Autonomous-Motorsports-Purdue/AMP_RCv2/(threads)

Thread 2 (2024-04-13):

Incorrect inductor footprint

benjamin-owen, 2024-04-13:
PCB footprint too small

Thread 3 (2024-04-13):

Missing switch on/off text

benjamin-owen, 2024-04-13:
Text should be added to PCB indicating which direction is on/off for the switch

benjamin-owen, 2024-05-23:
On is currently "down" position, consider flipping this.

Thread 4 (2024-04-13):

Jumper to bypass battery altogether

benjamin-owen, 2024-04-13:
A tiny slide switch or solder jumper should be added allowing the controller to be powered entirely via USB-C, not requiring a battery at all.

benjamin-owen, 2024-05-23:
Might not be needed, need to test and make sure using micro USB on Nucleo will power everything on board sufficiently.

Thread 7 (2024-09-01):

Anti-Spark Mosfet replacement

ZacharyGuM, 2024-09-01:
The overall design should be fine, The mosfets should be replaced. Focus on part selection and rerouting if necessary. https://github.com/Autonomous-Motorsports-Purdue/Anti-Spark/tree/main/Hardware
