Autonomous-Motorsports-Purdue/AMP_RCv2/hardware/AMP_RCv2.kicad_pcb

## KiCad design hardware/AMP_RCv2.kicad_pcb (2024-04-04)

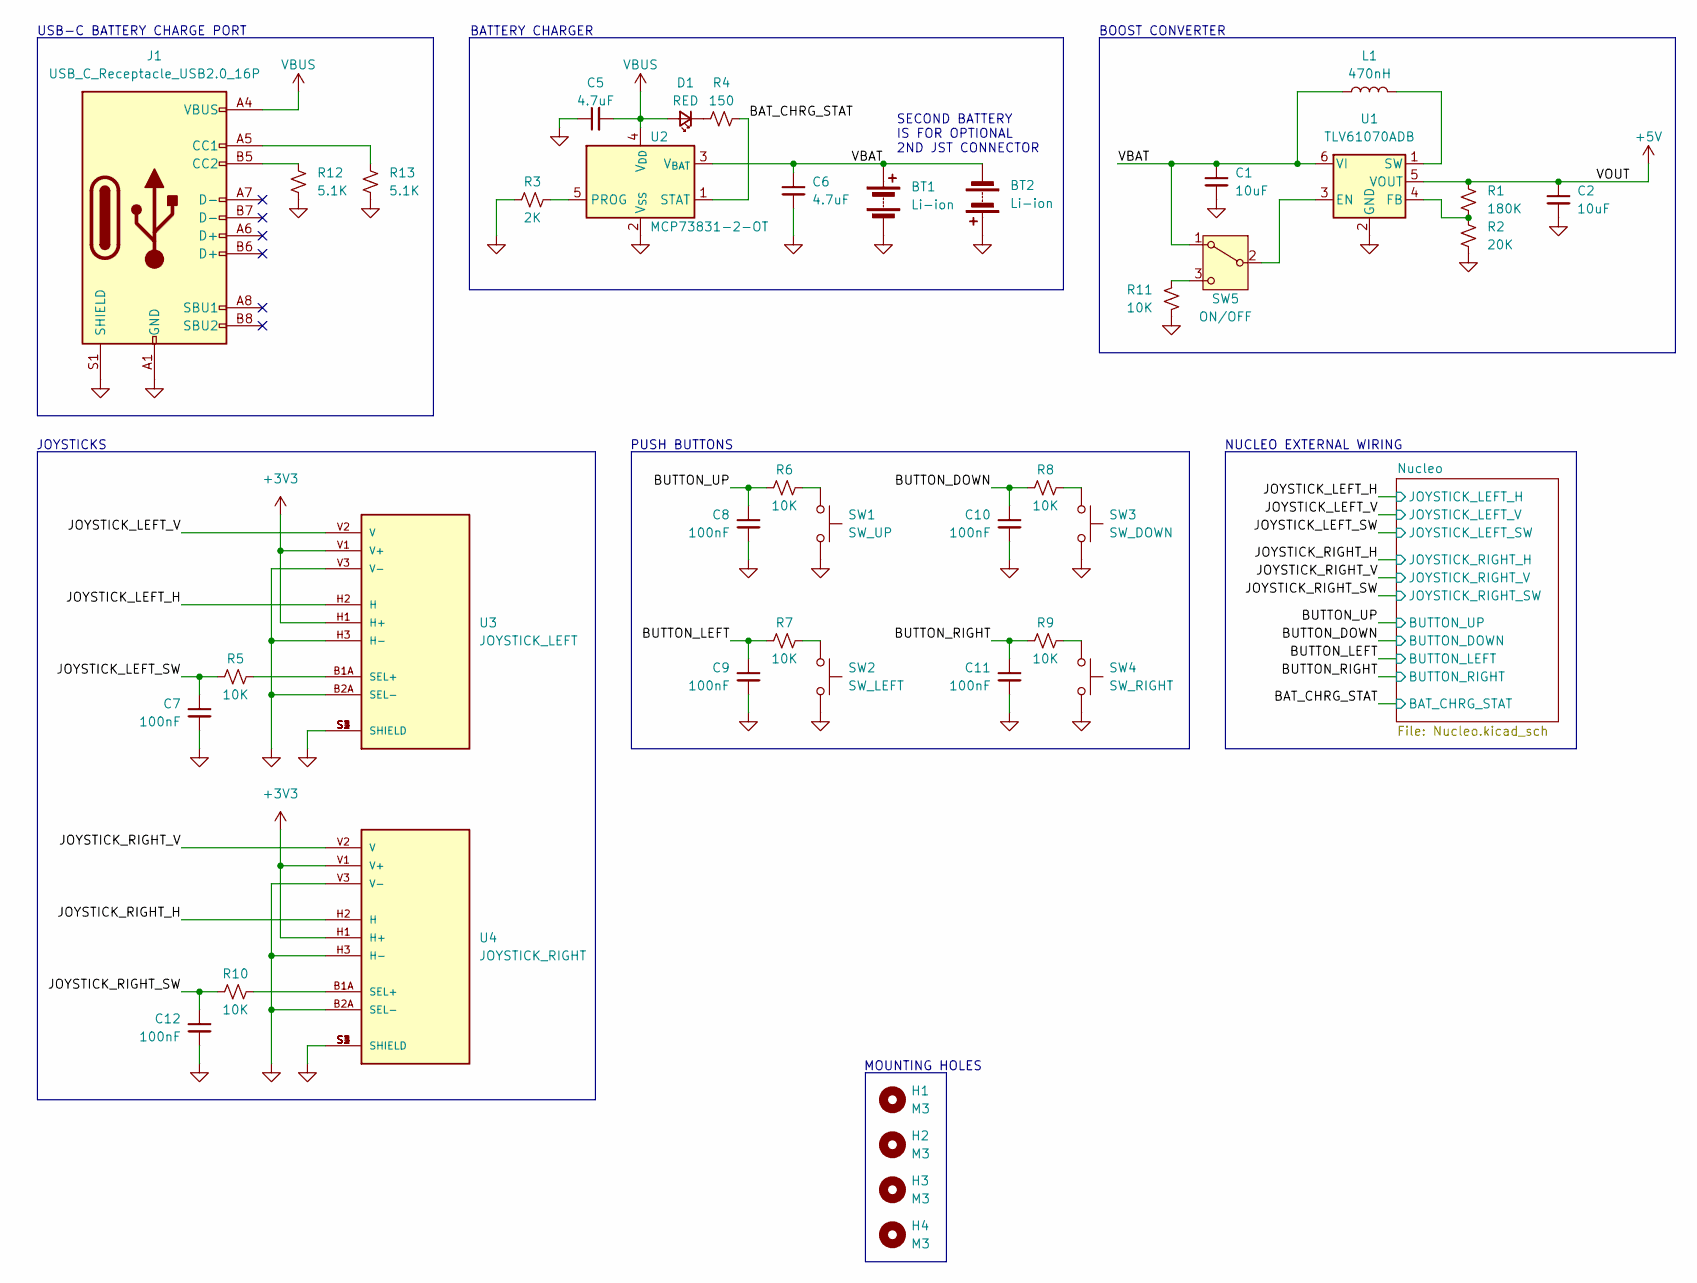
[picture p1: schematic AMP_RCv2.kicad_sch]

Parts:
BT1, BT2: Li-ion; JST_PH_B2B-PH-K_1x02_P2.00mm_Vertical
C1, C2: 10uF; C_0805_2012Metric_Pad1.18x1.45mm_HandSolder
C5, C6: 4.7uF; C_0805_2012Metric_Pad1.18x1.45mm_HandSolder
C7, C8, C9, C10, C11, C12: 100nF; C_0805_2012Metric_Pad1.18x1.45mm_HandSolder
D1: RED; LED_0805_2012Metric_Pad1.15x1.40mm_HandSolder
H1, H2, H3, H4: M3; MountingHole_3.2mm_M3
J1: USB_C_Receptacle_USB2.0_16P; USB_C_Receptacle_GCT_USB4085
L1: 470nH; L_Wuerth_MAPI-4030
R1: 180K; R_0805_2012Metric_Pad1.20x1.40mm_HandSolder
R2: 20K; R_0805_2012Metric_Pad1.20x1.40mm_HandSolder
R3: 2K; R_0805_2012Metric_Pad1.20x1.40mm_HandSolder
R4: 150; R_0805_2012Metric_Pad1.20x1.40mm_HandSolder
R5, R6, R7, R8, R9, R10, R11: 10K; R_0805_2012Metric_Pad1.20x1.40mm_HandSolder
R12, R13: 5.1K; R_0805_2012Metric_Pad1.20x1.40mm_HandSolder
SW1: SW_UP; SW_PUSH-12mm
SW2: SW_LEFT; SW_PUSH-12mm
SW3: SW_DOWN; SW_PUSH-12mm
SW4: SW_RIGHT; SW_PUSH-12mm
SW5: ON/OFF; SLW-121586-5A-D
U1: TLV61070ADB; SOT-23-6
U2: MCP73831-2-OT; SOT-23-5
U3: JOYSTICK_LEFT; XDCR_COM-09032; PARTREV N/A
U4: JOYSTICK_RIGHT; XDCR_COM-09032; PARTREV N/A

Connections:
+3V3: U3.H1 (H+), U3.V1 (V+), U4.H1 (H+), U4.V1 (V+); also elsewhere on the board
+5V: C2.1, R1.1, U1.5 (VOUT); also elsewhere on the board
/BAT_CHRG_STAT: R4.2, U2.1 (STAT); also elsewhere on the board
/BUTTON_DOWN: C10.1, R8.1; also elsewhere on the board
/BUTTON_LEFT: C9.1, R7.1; also elsewhere on the board
/BUTTON_RIGHT: C11.1, R9.1; also elsewhere on the board
/BUTTON_UP: C8.1, R6.1; also elsewhere on the board
/JOYSTICK_LEFT_H: U3.H2 (H); also elsewhere on the board
/JOYSTICK_LEFT_SW: C7.1, R5.1; also elsewhere on the board
/JOYSTICK_LEFT_V: U3.V2 (V); also elsewhere on the board
/JOYSTICK_RIGHT_H: U4.H2 (H); also elsewhere on the board
/JOYSTICK_RIGHT_SW: C12.1, R10.1; also elsewhere on the board
/JOYSTICK_RIGHT_V: U4.V2 (V); also elsewhere on the board
/VBAT: BT1.1 (+), BT2.2 (-), C1.1, C6.1, L1.1, SW5.1 (A), U1.6 (VI), U2.3 (V_{BAT})
GND: BT1.2 (-), BT2.1 (+), C1.2, C2.2, C5.1, C6.2, C7.2, C8.2, C9.2, C10.2, C11.2, C12.2, J1.A1 (GND), J1.A12 (GND), J1.B1 (GND), J1.B12 (GND), J1.S1 (SHIELD), R2.2, R3.1, R11.2, R12.2, R13.2, SW1.2, SW2.2, SW3.2, SW4.2, U1.2 (GND), U2.2 (V_{SS}), U3.B2A (SEL-), U3.H3 (H-), U3.S1 (SHIELD), U3.S2 (SHIELD), U3.S3 (SHIELD), U3.S4 (SHIELD), U3.V3 (V-), U4.B2A (SEL-), U4.H3 (H-), U4.S1 (SHIELD), U4.S2 (SHIELD), U4.S3 (SHIELD), U4.S4 (SHIELD), U4.V3 (V-); also elsewhere on the board
unnamed: D1.1 (K), R4.1
unnamed: J1.A5 (CC1), R13.1
unnamed: J1.B5 (CC2), R12.1
unnamed: R6.2, SW1.1
unnamed: R7.2, SW2.1
unnamed: R8.2, SW3.1
unnamed: R9.2, SW4.1
unnamed: SW5.2 (B), U1.3 (EN)
unnamed: R11.1, SW5.3 (C)
unnamed: R1.2, R2.1, U1.4 (FB)
unnamed: L1.2, U1.1 (SW)
unnamed: R3.2, U2.5 (PROG)
unnamed: R5.2, U3.B1A (SEL+)
unnamed: R10.2, U4.B1A (SEL+)
VBUS: C5.2, D1.2 (A), J1.A4 (VBUS), J1.A9 (VBUS), J1.B4 (VBUS), J1.B9 (VBUS), U2.4 (V_{DD})

Notes on the sheet:
JOYSTICKS
BATTERY CHARGER
MOUNTING HOLES
BOOST CONVERTER
USB-C BATTERY CHARGE PORT
NUCLEO EXTERNAL WIRING
PUSH BUTTONS
SECOND BATTERY IS FOR OPTIONAL 2ND JST CONNECTOR

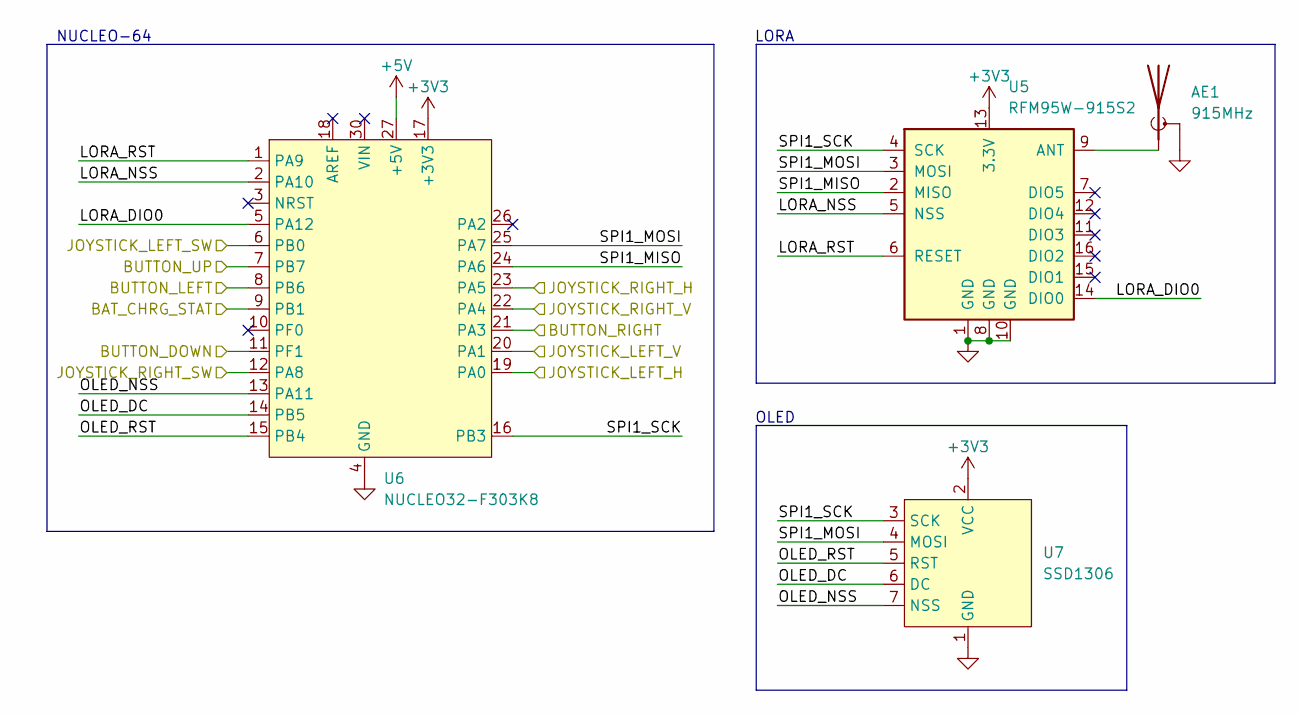
[picture p2: schematic Nucleo.kicad_sch, AMP_RCv2]

Parts:
AE1: 915MHz; SMA_Amphenol_132291_Vertical
U5: RFM95W-915S2; HOPERF_RFM9XW_SMD
U6: NUCLEO32-F303K8; NUCLEO32
U7: SSD1306; SSD1306_SPI

Connections:
+3V3: U5.13 (3.3V), U6.17 (+3V3), U7.2 (VCC); also elsewhere on the board
+5V: U6.27 (+5V); also elsewhere on the board
/BAT_CHRG_STAT: U6.9 (PB1); also elsewhere on the board
/BUTTON_DOWN: U6.11 (PF1); also elsewhere on the board
/BUTTON_LEFT: U6.8 (PB6); also elsewhere on the board
/BUTTON_RIGHT: U6.21 (PA3); also elsewhere on the board
/BUTTON_UP: U6.7 (PB7); also elsewhere on the board
/JOYSTICK_LEFT_H: U6.19 (PA0); also elsewhere on the board
/JOYSTICK_LEFT_SW: U6.6 (PB0); also elsewhere on the board
/JOYSTICK_LEFT_V: U6.20 (PA1); also elsewhere on the board
/JOYSTICK_RIGHT_H: U6.23 (PA5); also elsewhere on the board
/JOYSTICK_RIGHT_SW: U6.12 (PA8); also elsewhere on the board
/JOYSTICK_RIGHT_V: U6.22 (PA4); also elsewhere on the board
/Nucleo/LORA_DIO0: U5.14 (DIO0), U6.5 (PA12)
/Nucleo/LORA_NSS: U5.5 (NSS), U6.2 (PA10)
/Nucleo/LORA_RST: U5.6 (RESET), U6.1 (PA9)
/Nucleo/OLED_DC: U6.14 (PB5), U7.6 (DC)
/Nucleo/OLED_NSS: U6.13 (PA11), U7.7 (NSS)
/Nucleo/OLED_RST: U6.15 (PB4), U7.5 (RST)
/Nucleo/SPI1_MISO: U5.2 (MISO), U6.24 (PA6)
/Nucleo/SPI1_MOSI: U5.3 (MOSI), U6.25 (PA7), U7.4 (MOSI)
/Nucleo/SPI1_SCK: U5.4 (SCK), U6.16 (PB3), U7.3 (SCK)
GND: AE1.2 (Shield), U5.1 (GND), U5.8 (GND), U5.10 (GND), U6.4 (GND), U6.29 (GND), U7.1 (GND); also elsewhere on the board
unnamed: AE1.1 (A), U5.9 (ANT)

Notes on the sheet:
NUCLEO-64
OLED
LORA

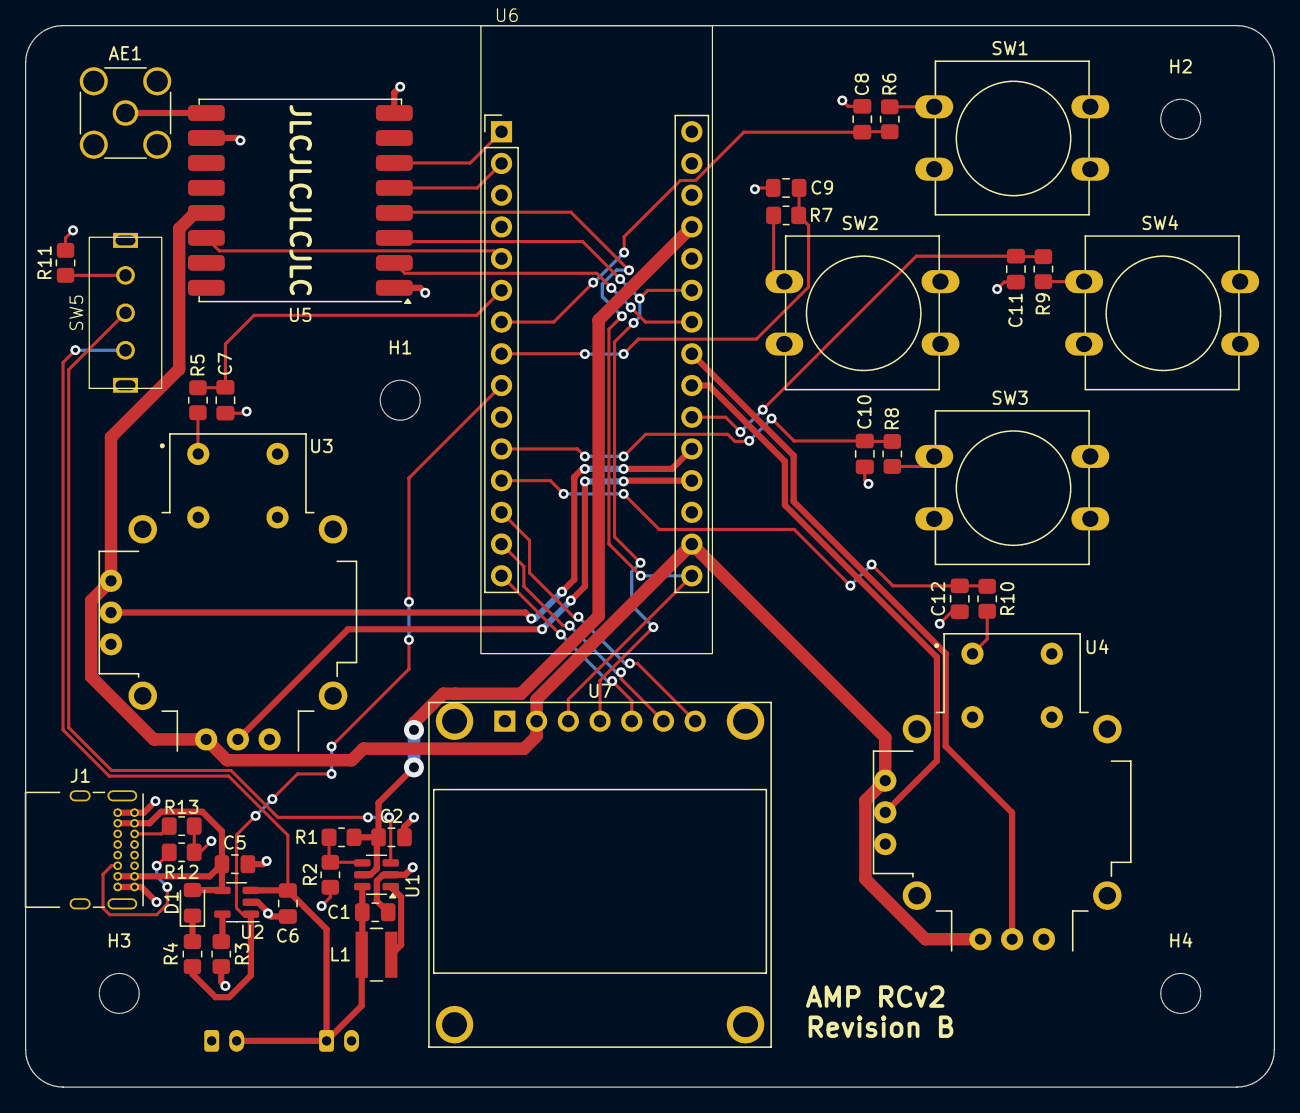
[picture p3: board AMP_RCv2.kicad_pcb from above]

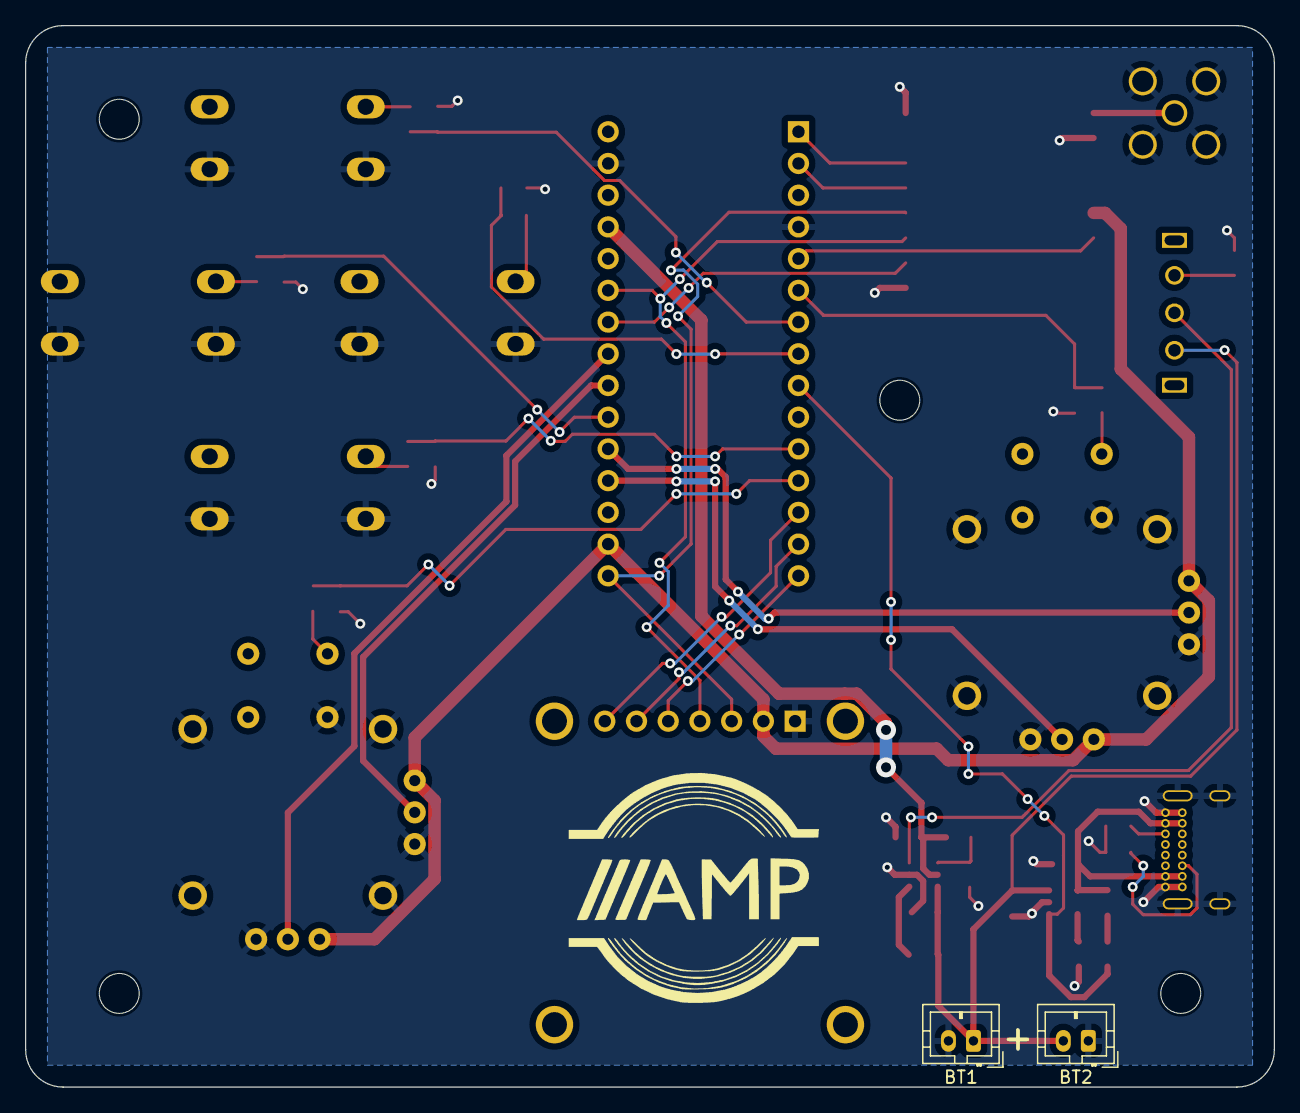
[picture p4: board AMP_RCv2.kicad_pcb from below]

Board: 2 copper layers, 100.0 x 85.0 mm, 45 parts (2 on the bottom side), 40 nets.
