Autonomous-Motorsports-Purdue/AMP_RCv2/firmware/AMP_RCv2/Core/Src/main.c

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
/* Includes ------------------------------------------------------------------*/
#include "main.h"

/* USER CODE BEGIN Includes */
#include "stdio.h"
#include "string.h"
#include "LoRa.h"
#include "app_statemachine.h"
/* USER CODE END Includes */

ADC_HandleTypeDef hadc1;
ADC_HandleTypeDef hadc2;

SPI_HandleTypeDef hspi1;

TIM_HandleTypeDef htim1;

UART_HandleTypeDef huart2;

void SystemClock_Config(void);
static void MX_GPIO_Init(void);
static void MX_USART2_UART_Init(void);
static void MX_SPI1_Init(void);
static void MX_ADC1_Init(void);
static void MX_ADC2_Init(void);
static void MX_TIM1_Init(void);
/* USER CODE BEGIN PFP */
LoRa myLoRa;
Cont_Info Controller;
int mode = 1;
int auto_mode = 0;

/* USER CODE END PFP */

/* USER CODE BEGIN 0 */
void HAL_GPIO_EXTI_Callback(uint16_t GPIO_Pin) {
	switch (GPIO_Pin) {
	case (BTN_UP_Pin): //BUtton up pin
		switch (mode) {
		case (3):
			mode = 1; // 1 == idle, 2 == slow, 3 == fast
			Controller = App_StateMachine_Update(Controller, mode);
			break;
		default:
			mode += 1;
			Controller = App_StateMachine_Update(Controller, mode);
			break;
		}
		break;
	case (BTN_RIGHT_Pin): //Emergency state
		mode = 0; // Emergency mode
		Controller = App_StateMachine_Update(Controller, mode);
		break;

	case (BTN_DOWN_Pin): //Automotive vs not automotive state
		switch (auto_mode) {
		case (0):
			auto_mode = 1;
			break;
		default:
			auto_mode = 0;
			break;
		}
	default:
		break;
	}
}
/* USER CODE END 0 */

/**
  * @brief  The application entry point.
  * @retval int
  */
int main(void)
{

  /* USER CODE BEGIN 1 */
	myLoRa = newLoRa();
	myLoRa.CS_port =  LORA_NSS_GPIO_Port; //NSS_GPIO_Port;
	myLoRa.CS_pin =  LORA_NSS_Pin;; // NSS_Pin;
	myLoRa.reset_port = LORA_RST_GPIO_Port; // RESET_GPIO_Port;
	myLoRa.reset_pin = LORA_RST_Pin; //RESET_Pin;
	myLoRa.DIO0_port = LORA_DIO0_GPIO_Port; //DIO0_GPIO_Port;
	myLoRa.DIO0_pin = LORA_DIO0_Pin; //DIO0_Pin;
	myLoRa.hSPIx = &hspi1;
	myLoRa.frequency = 915;             // default = 433 MHz

	Controller = newController();


  /* USER CODE END 1 */

  /* MCU Configuration--------------------------------------------------------*/

  /* Reset of all peripherals, Initializes the Flash interface and the Systick. */
  HAL_Init();

  /* Configure the system clock */
  SystemClock_Config();

  /* Initialize all configured peripherals */
  MX_GPIO_Init();
  MX_USART2_UART_Init();
  MX_SPI1_Init();
  MX_ADC1_Init();
  MX_ADC2_Init();
  MX_TIM1_Init();
  /* USER CODE BEGIN 2 */
	HAL_TIM_Base_Start_IT(&htim1);
	HAL_ADC_Start(&hadc1);
	HAL_ADC_Start(&hadc2);
	LoRa_reset(&myLoRa);
		uint16_t lora_status = LoRa_init(&myLoRa);
		if (lora_status == LORA_OK)
		{
			int a = 0;
//			Driver_UART_Transmit(NUCLEO, "LoRa OK\r\n\r\n");
		}
		else
		{
			int b = 0;
//			Driver_UART_Transmit(NUCLEO, "LoRa FAILED\r\n\r\n");
		}
	//LoRa_init(&myLoRa);
  /* USER CODE END 2 */

  /* Infinite loop */
  /* USER CODE BEGIN WHILE */
	while (1) {
    /* USER CODE END WHILE */

    /* USER CODE BEGIN 3 */
	}
  /* USER CODE END 3 */
}

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
/* USER CODE BEGIN 4 */
void HAL_TIM_PeriodElapsedCallback(TIM_HandleTypeDef *htim) {
	if (htim->Instance == TIM1) {
		//Controller = Controller_steer_thrust(Controller);
		Controller.steer_input = HAL_ADC_GetValue(&hadc1); //controller input
		Controller.thrust_input = HAL_ADC_GetValue(&hadc2); //controller input
		Controller = Controller_steer_thrust(Controller); // gives actual speed and steering
		//char *message = Controller_data(Controller); // sends and receives data through LoRa

	}
}
/* USER CODE END 4 */
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
