Autonomous-Motorsports-Purdue/AMP_RCv2/firmware/AMP_RCv2/AMP_RCv2.ioc

Mcu.UserName=STM32F303K8Tx
PA0.GPIO_Label=JOYSTICK_LEFT_H
PA0.Signal=ADC1_IN1
PA1.GPIO_Label=JOYSTICK_LEFT_V
PA1.Signal=ADC1_IN2
PA10.GPIO_Label=LORA_NSS
PA10.Signal=GPIO_Output
PA11.GPIO_Label=OLED_NSS
PA11.Signal=GPIO_Output
PA12.GPIO_Label=LORA_DIO0
PA12.Signal=GPXTI12
PA13.GPIO_Label=SWDIO
PA13.Signal=SYS_JTMS-SWDIO
PA14.GPIO_Label=SWCLK
PA14.Signal=SYS_JTCK-SWCLK
PA15.GPIO_Label=VCP_RX
PA15.Signal=USART2_RX
PA2.GPIO_Label=VCP_TX
PA2.Signal=USART2_TX
PA3.GPIO_Label=BTN_RIGHT
PA3.Signal=GPXTI3
PA4.GPIO_Label=JOYSTICK_RIGHT_V
PA4.Signal=ADC2_IN1
PA5.GPIO_Label=JOYSTICK_RIGHT_H
PA5.Signal=ADC2_IN2
PA6.Signal=SPI1_MISO
PA7.Signal=SPI1_MOSI
PA8.GPIO_Label=JOYSTICK_R_SW
PA8.Signal=GPXTI8
PA9.GPIO_Label=LORA_RST
PA9.Signal=GPIO_Output
PB0.GPIO_Label=JOYSTICK_L_SW
PB0.Signal=GPXTI0
PB1.GPIO_Label=BAT_CHRG_STAT
PB1.Signal=GPIO_Input
PB3.Signal=SPI1_SCK
PB4.GPIO_Label=OLED_RST
PB4.Signal=GPIO_Output
PB5.GPIO_Label=OLED_DC
PB5.Signal=GPIO_Output
PB6.GPIO_Label=BTN_LEFT
PB6.Signal=GPXTI6
PB7.GPIO_Label=BTN_UP
PB7.Signal=GPXTI7
