Autonomous-Motorsports-Purdue/AMP_RCv2/(commit log)

2024-03-14 Schematic and placing of most parts
    [AMP_RCv2.kicad_pcb, AMP_RCv2.kicad_sch]
2024-03-15 Finish routing
    [AMP_RCv2.kicad_pcb, AMP_RCv2.kicad_sch]
2024-03-15 KiCAD 8.0 migration
    [AMP_RCv2.kicad_sch]
2024-03-27 Ignore KiCAD lck files
2024-03-27 Fix incorrect power switch wiring
    [AMP_RCv2.kicad_pcb, AMP_RCv2.kicad_sch]
2024-03-27 Replace USB-C port
    [AMP_RCv2.kicad_pcb, AMP_RCv2.kicad_sch]
2024-03-27 Increase ground plane size
    [AMP_RCv2.kicad_pcb]
2024-03-28 Replace boost converter
    [AMP_RCv2.kicad_pcb, AMP_RCv2.kicad_sch]
2024-03-28 Clean up schematic and add optional second battery connector
    [AMP_RCv2.kicad_pcb, AMP_RCv2.kicad_sch, Nucleo.kicad_sch]
2024-03-28 Update 3D models
    [AMP_RCv2.kicad_pcb]
2024-04-04 Finishing touches
    [AMP_RCv2.kicad_pcb, AMP_RCv2.kicad_sch, Nucleo.kicad_sch]
2024-04-04 Change text size
    [AMP_RCv2.kicad_pcb]
2024-05-02 Revert "Remove extra Eclipse files"
    This reverts commit c2f57aa422bf200500a915565af12b525244114b.
    [LoRa.c, LoRa.h]
